wagiminator/CH32X035-USB-PD-Adapter/hardware/USB_PD_Adapter_BOM.tsv

ID | Name | Designator | Footprint | Quantity | Manufacturer Part | Manufacturer | Supplier | Supplier Part
1 | 100n | C1,C4 | C_0603 | 2 | CC0603KRX7R9BB104 | YAGEO | LCSC | C14663
2 | 10u | C2 | C_0603 | 1 | GRM188R6YA106MA73D | Murata Electronics | LCSC | C194427
3 | 10u | C3 | C_0603 | 1 | CL10A106KP8NNNC | SAMSUNG | LCSC | C19702
4 | GT-USB-7010ASV | CN1 | USB-C-7010ASV-SX | 1 | GT-USB-7010ASV | G-Switch(品赞) | LCSC | C2988369
5 | OLED 0.91 | CN2 | I2C OLED 0.91 | 1 | SSD1306 I2C OLED
6 | KF301-2P | CN3 | KF301-2P | 1 | KF301-5.0-2P | Cixi Kefa Elec | LCSC | C474881
7 | 1k | R1 | 0603 | 1 | 0603WAF1001T5E | UniOhm | LCSC | C21190
8 | 5k1 | R2,R3 | 0603 | 2 | 0603WAF5101T5E | UNI-ROYAL(厚声) | LCSC | C23186
9 | R010 | R4 | 2512 | 1 | 25121WF100MT4E | Uniroyal Elec | LCSC | C127692
10 | BOOT | SW1 | SW_SMD_TS24CA | 1 | TS24CA | SHOU HAN(首韩) | LCSC | C393942
11 | RST | SW2 | SW_SMD_TS24CA | 1 | TS24CA | SHOU HAN(首韩) | LCSC | C393942
12 | DEC | SW3 | SW_SMD_TS24CA | 1 | TS24CA | SHOU HAN(首韩) | LCSC | C393942
13 | INC | SW4 | SW_SMD_TS24CA | 1 | TS24CA | SHOU HAN(首韩) | LCSC | C393942
14 | CH32X035F7P6 | U1 | TSSOP-20 | 1 | CH32X035F7P6 | WCH(南京沁恒) | LCSC
15 | HT7533-1 | U2 | SOT-89-3_BR | 1 | HT7533-1 | HOLTEK | LCSC | C14289
16 | INA219AIDR | U3 | SOP-8_150MIL | 1 | INA219AIDR | TI | LCSC | C138706
