wagiminator/CH32X035-USB-PD-Adapter/hardware/USB_PD_Adapter_schematic.pdf

## Microcontroller

## Buttons

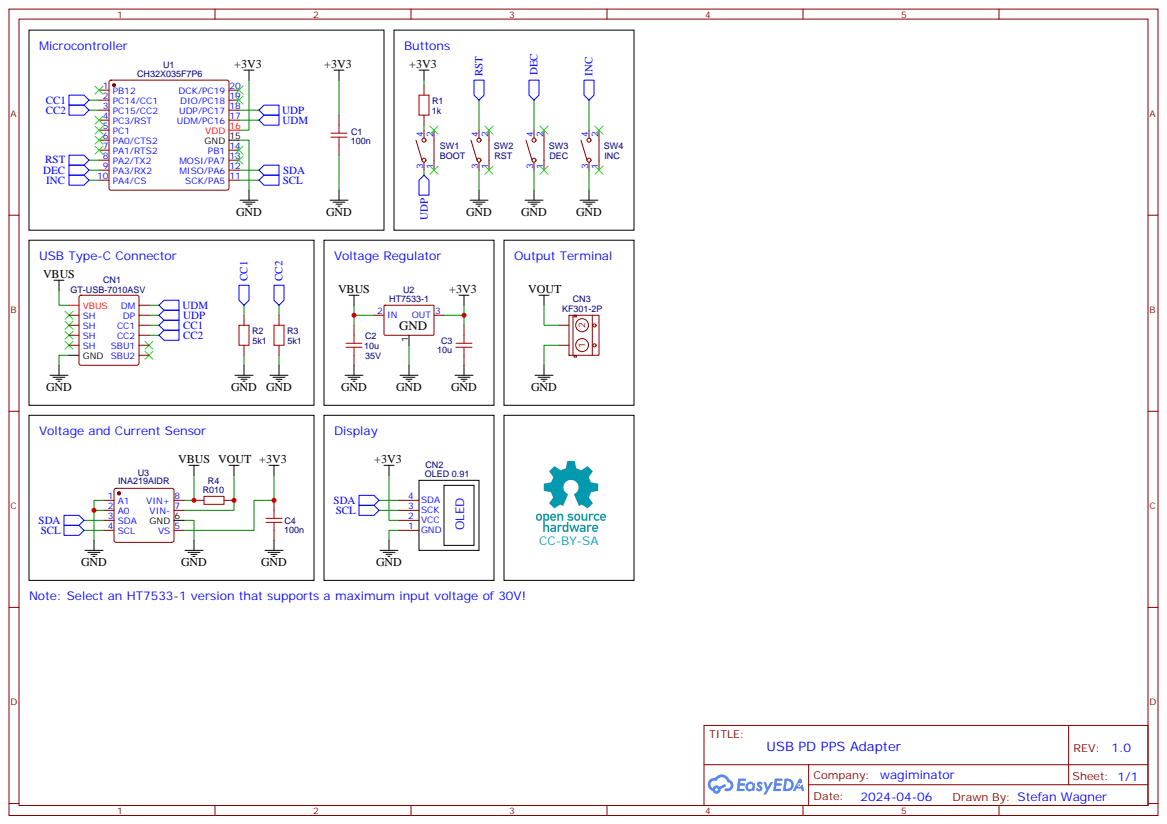
[picture p7: page 1]

Voltage and Current Sensor

Note: Select an HT7533-1 version that supports a maximum input voltage of 30V!

Drawn By: Stefan Wagner
