wagiminator/CH32X035-USB-PD-Adapter/(threads)

Thread 1 (2024-04-23):

Disable output while changing voltage

X-Ryl669, 2024-04-23:
I don't know if it's possible, but it's usually a good idea to disable the output circuit while the voltage is selected. This allows to skip unscrewing the output pin, change the voltage and screw it back.

Ideally, the output circuit should be off, you select the voltage, and, for example, press the reset button to enable it. That way you don't send a 5V on a 1.8V circuit at boot, or worse.

wagiminator, 2024-04-23:
Hi, you can install a P-Channel MOSFET with a few supporting components in front of or behind the shunt (depending on what you want to see displayed when switched off). Make sure that it can withstand the appropriate voltages and currents. Then you can switch the voltage at the output on and off via the microcontroller.

With this board, that was intentionally not what I wanted. I intend to build an expanded version at some point in the future, with protection circuits, bigger display, a rotary encoder for voltage selection and maybe a current limit feature. There should also be the possibility of an interruption.

Thread 2 (2024-12-16):

Power Supply restart when inc/dec buttons are pressed for more than 15 seconds

aoc99htl, 2024-12-16:
Hello,
... first of all, thanks for the great project.

I have built it; unfortunately I have noticed the following behaviour:
I am using the QUAT Power, USB charger P815 65W power supply from Pollin. If I press the INCREASE or DECREASE button for more than 15 seconds, the power supply restarts.
I suspect this is a similar problem to the one described in [USB-PD-Tester, issue #5](https://github.com/wagiminator/CH32X035-USB-PD-Tester/issues/5).
As a workaround, I have added a PD_negotiate(); in line 191; and the problem seems to be solved now. However, I do not know if too many negotiations are now performed during the keystroke.

I would appreciate it if you could check this.

Regards,
   Michael

----------------------------
...
   else {
      keydelay = 50;
      PD_setVoltage(setvolt);
      DLY_ms(10);
    }

    PD_negotiate();   //// NEW ////
  }
}

wagiminator, 2024-12-20:
Oh yes, you're right. Thank you for the hint.

Thread 3 (2024-12-16):

Power supply restarts when voltage > 5900mV

aoc99htl, 2024-12-16:
When I use your project with the QUAT Power, USB charger P812 20W from Pollin, I see the following erroneous behaviour:

When the voltage goes above 5900mV, the power supply performs a restart.

The following point is important:
The power supply has the following profile
(1) 5000mV 3000mA
(2) 9000mV 2220mA
(3) 12000mV 1670mA
(4) 3300mV - 5900mV; 3000mA
(5) 3300mV - 11000mV; 1800mA

I.e. the power supply offers two PPS profiles, but it seems that only the 1st profile (i.e. [4]) is ever used - hence the restart when above 5900mV (e.g. 5920mV). I have also noticed that a restart also occurs at 9000mV - i.e. profile (2) is not requested at all. If I read the lines of code in PD_setVoltage correctly, this should be the case, but I can't see an error here.
Could it be related to the maximum current?

At the moment I don't have any external hardware to record the USB CC communication.
Any ideas would be appreciated.

Kind regards,
   Michael

wagiminator, 2024-12-20:
That's interesting and something I hadn't noticed before. At first glance, I can't spot any errors in the code either. In my opinion, the issue doesn't seem to be related to the current. Unfortunately, I don't have the time right now to dive deeper into troubleshooting, but I'll definitely add this problem to my to-do list.

wagiminator, 2024-12-21:
Oh yes, thank you, fixed now.
What kind of test environment are you using? I think I might need something like that too...

aoc99htl, 2024-12-31:
I found a great website that describes experiences with USB-PD debugging:
https://community.element14.com/technologies/power-management/b/blog/posts/usb-pd---cc-decoding-adventures

And this is my test setup:
LM393,
100k and 15k resistor and a
CY7C68013A demo board (e.g. AliExpress)

Decoding with PulseView - works perfectly!

Since everything is currently built on a breadboard, I'm thinking about designing a small circuit board...

Thread 4 (2024-12-31):

OLED display occasionally works

aoc99htl, 2024-12-31:
Sorry to start a new issue...

I've noticed that the OLED display sometimes works and sometimes doesn't.

A

DLY_ms(50);

before

OLED_init();
(main.c)

solves the problem.

So... I would suggest to give the OLED display controller a little more time to power-up... just to be on the safe side.
